jdoscher/Recovery-Kit-2/README.md

# Recovery Kit 2
 My 2024 follow-up to the original 2019 Recovery kit, this build has several updates!
