jdoscher/Recovery-Kit-2/doscher.com Recovery Kit Version Two CAD and STL Files/doscher.com - Recovery Kit Version Two GPIO Tray.stl

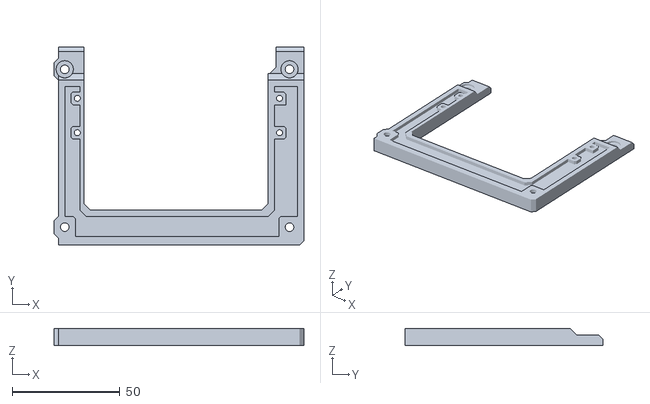
[picture p9: CAD file, 2025-02-13]
doscher.com Recovery Kit Version Two CAD and STL Files/doscher.com - Recovery Kit Version Two GPIO Tray.stl
116.2 x 92.0 x 8.00
