jdoscher/Recovery-Kit-2/doscher.com Recovery Kit Version Two CAD and STL Files/doscher.com - Recovery Kit Version Two Battery Rear.stl

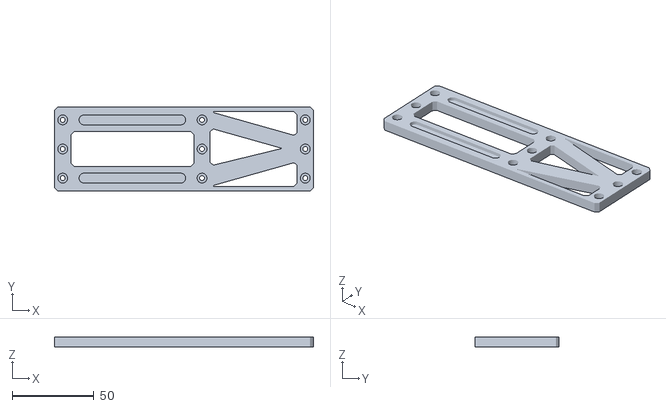
[picture p10: CAD file, 2025-02-13]
doscher.com Recovery Kit Version Two CAD and STL Files/doscher.com - Recovery Kit Version Two Battery Rear.stl
158.0 x 51.5 x 6.00
