jdoscher/Recovery-Kit-2/doscher.com Recovery Kit Version Two CAD and STL Files/doscher.com - Recovery Kit Version Two - Primary Frame.stl

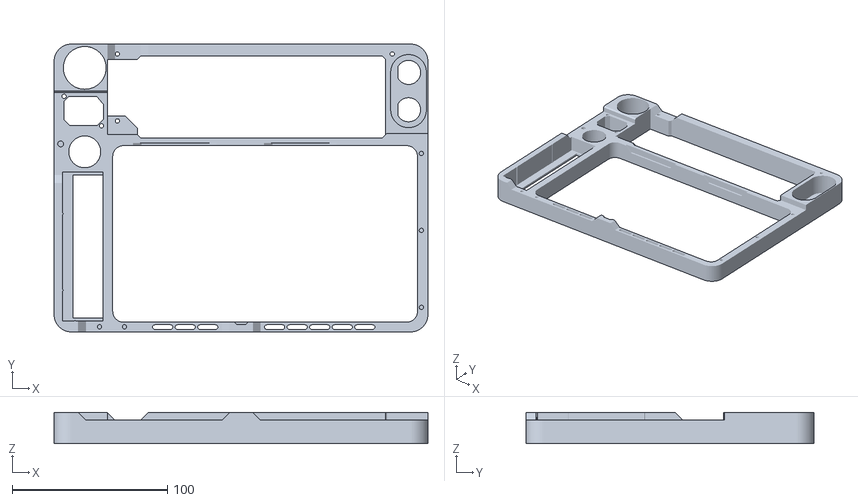
[picture p11: CAD file, 2025-02-13]
doscher.com Recovery Kit Version Two CAD and STL Files/doscher.com - Recovery Kit Version Two - Primary Frame.stl
240.5 x 185.2 x 20.0
