jdoscher/Recovery-Kit-2/doscher.com Recovery Kit Version Two CAD and STL Files/doscher.com - Recovery Kit Version Two Display Bracket Left.stl

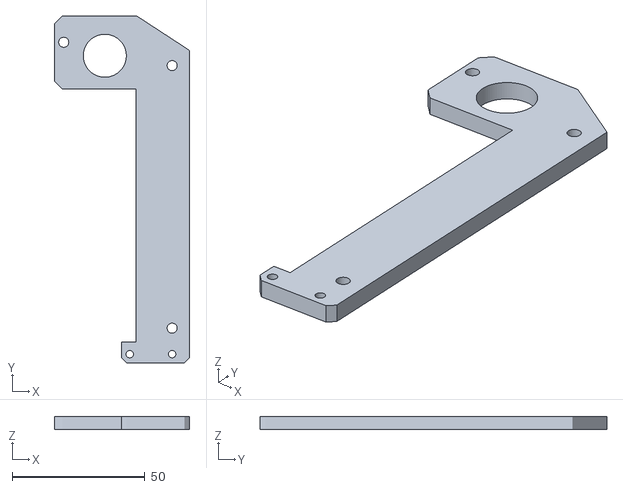
[picture p12: CAD file, 2025-02-13]
doscher.com Recovery Kit Version Two CAD and STL Files/doscher.com - Recovery Kit Version Two Display Bracket Left.stl
50.9 x 130.8 x 5.00
