jdoscher/Recovery-Kit-2/doscher.com Recovery Kit Version Two CAD and STL Files/doscher.com - Recovery Kit Version Two Planck v7 Keyboard Tray.stl

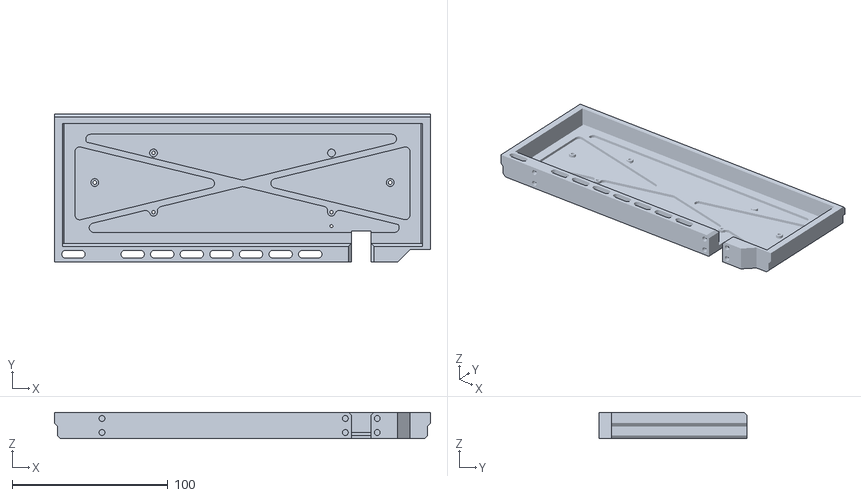
[picture p16: CAD file, 2025-02-13]
doscher.com Recovery Kit Version Two CAD and STL Files/doscher.com - Recovery Kit Version Two Planck v7 Keyboard Tray.stl
241.3 x 95.0 x 17.0
