jdoscher/Recovery-Kit-2/doscher.com Recovery Kit Version Two CAD and STL Files/doscher.com - Recovery Kit Version Two Planck Factory Case Shim for Pelican 1300 Lid - Side B.stl

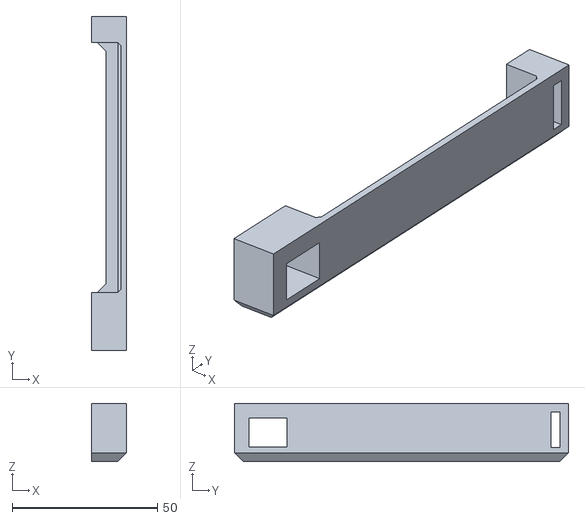
[picture p18: CAD file, 2025-02-13]
doscher.com Recovery Kit Version Two CAD and STL Files/doscher.com - Recovery Kit Version Two Planck Factory Case Shim for Pelican 1300 Lid - Side B.stl
12.0 x 115.0 x 20.0
