jdoscher/Recovery-Kit-2/doscher.com Recovery Kit Version Two CAD and STL Files/doscher.com - Recovery Kit Version Two USB-C Keyboard Brace.stl

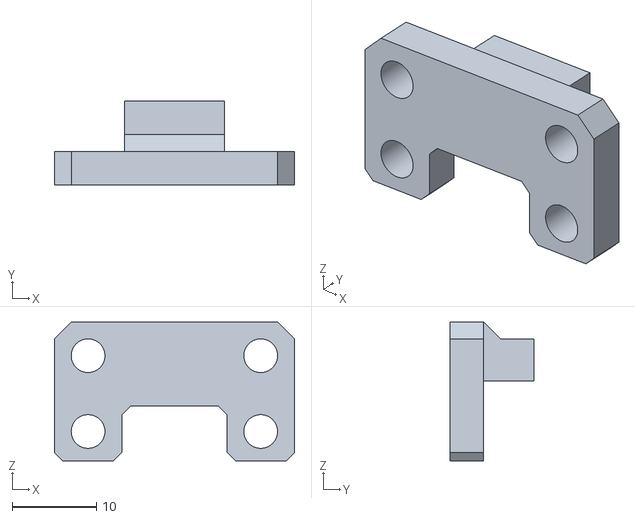
[picture p23: CAD file, 2025-02-13]
doscher.com Recovery Kit Version Two CAD and STL Files/doscher.com - Recovery Kit Version Two USB-C Keyboard Brace.stl
28.5 x 10.0 x 16.5
