jdoscher/Recovery-Kit-2/(list of files, cad)

Other CAD files:
doscher.com Recovery Kit Version Two CAD and STL Files/doscher.com - Recovery Kit Version Two Planck Factory Case Shim for Pelican 1300 Lid - Side A.stl
